Boomer-54/pico-loconet-servo16/loconet-pico.pdf

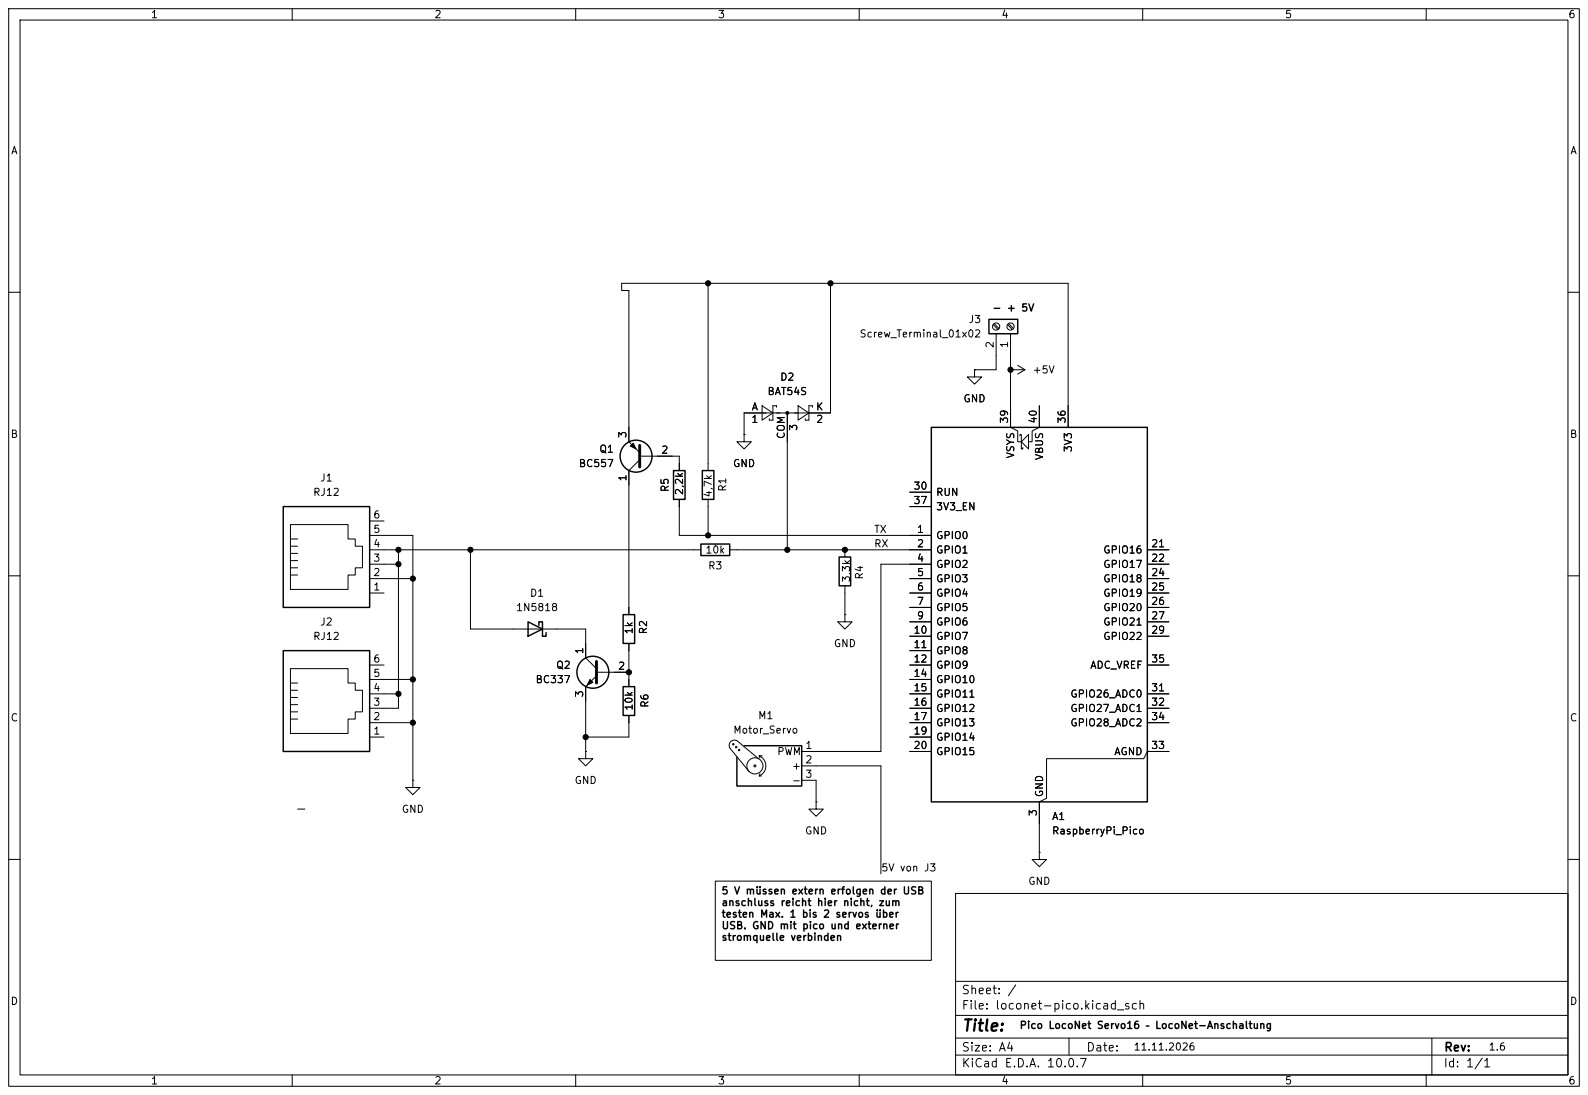
[picture p1: page 1]

5 V müssen extern erfolgen der USB
anschluss reicht hier nicht, zum

Size: A4 | Rev:
KiCad E.D.A. 10.0.7 | Id: 1/1
