Boomer-54/pico-loconet-servo16/(commit log)

2026-11-10 Update README with LocoNet circuit and servo notes
    Added a section for the LocoNet circuit diagram and notes on servo power requirements.
2026-11-10 Update README with forum link for servo discussion
    Added link to Rocrail forum discussion for 16-servo variant.
2026-11-11 Clarify Servo 9–16 support in Rocrail dialog
    Updated information regarding Servo 9–16 compatibility in Rocrail dialog, including resolution details and forum link.
